has-c/Fisher-Paykel-Linear-Controller-/README.md

# Fisher&Paykel Appliances Project: Linear Motor Controller

This repo contains a 3rd stage electrical engineering undergraduate project. The project consisted of creating a linear motor controller. The controller used an ATMEGA328P and an H-bridge for motor control. Embedded C was used to write this project. 
Final report is attached in the repo.
