has-c/Fisher-Paykel-Linear-Controller-/(commit log)

2018-09-19 changes in the PWM ISR
2018-09-20 changes to the uart receive stuff
2018-09-26 added current relationship
2018-09-26 edits to the pumpingEffort intepretation function
2018-09-28 changes to code struct for pwm functions
2018-10-06 relationship is broken got to fix
    [main.c, uart.c]
2018-10-06 ADC Calculation and Interpreting
2018-10-07 Fixed ADC Current
2018-10-08 Full UART Receive Capability
    Can now receive and extract flowrate request
2018-10-08 voltage/current sensing v1
2018-10-09 uart receive code added to main code file
2018-10-09 tested ADC code and uart receive together
2018-10-09 added low power relationship
2018-10-09 motor movement
2018-10-10 Fix to last commit
    [adc.c, main.c, uart.c]
2018-10-10 fixed uC power
